TylerSeiford/Teensy4-Breakout/README.md

# Teensy4-Breakout
 Uno style breakout for Teensy4.0
