TylerSeiford/Teensy4-Breakout/Teensy4-Breakout.kicad_pcb

## KiCad design Teensy4-Breakout.kicad_pcb (2019-11-09)

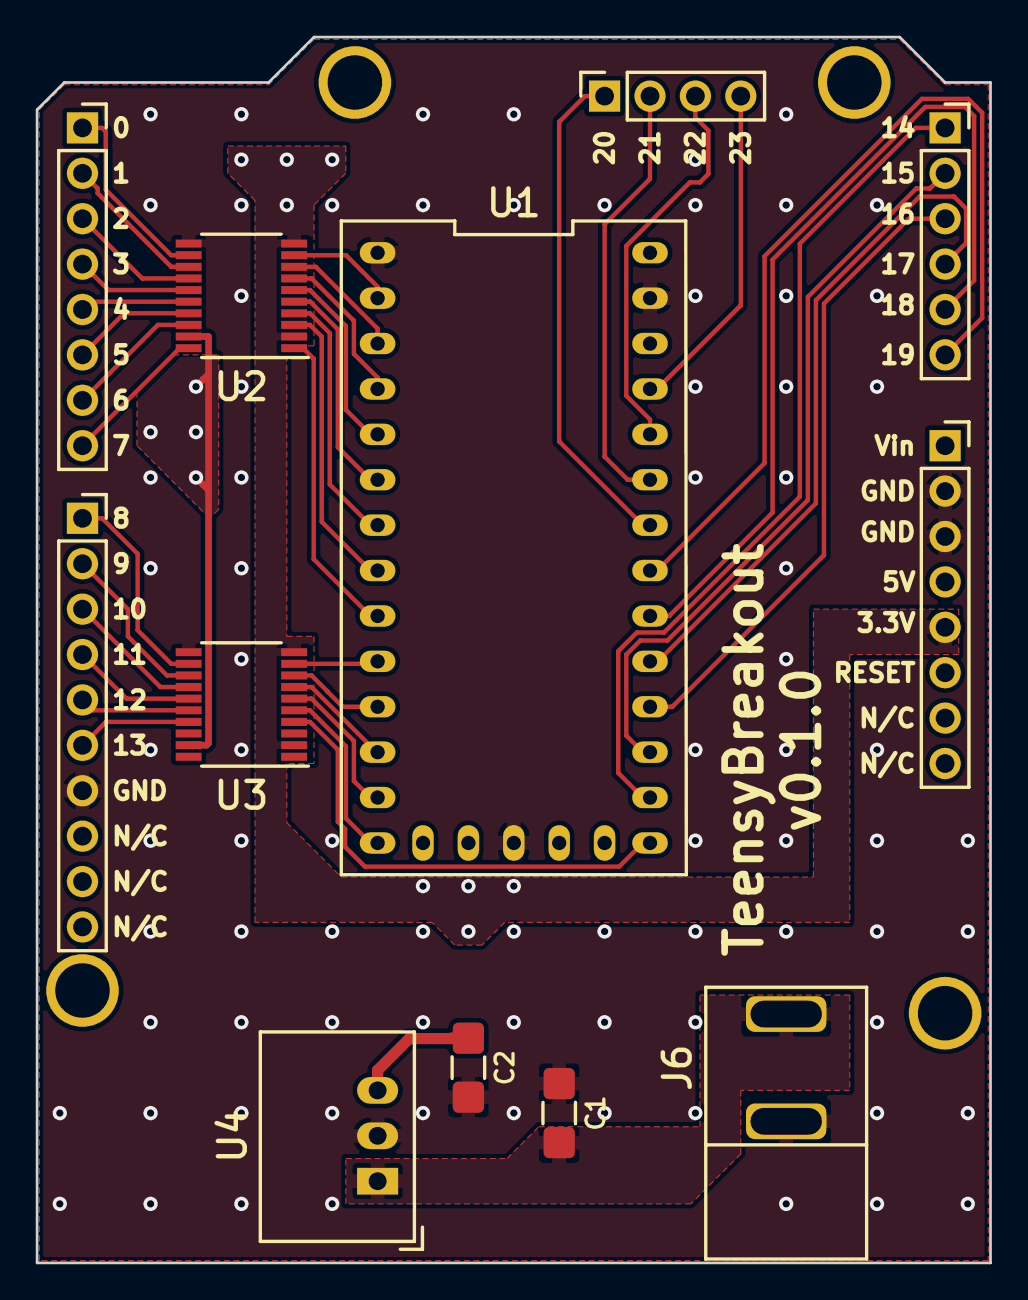
[picture p1: board Teensy4-Breakout.kicad_pcb from above]

Board: 2 copper layers, 53.3 x 68.6 mm, 16 parts (0 on the bottom side), 42 nets.

Parts:
C1, C2: 10uF; C_1206_3216Metric_Pad1.42x1.75mm_HandSolder
H1, H2, H3, H4: MountingHole; Hole
J1: DIO 0-7; J1
J2: DIO 8-13, GND, NC x 3; J2
J3: AI 6-9/DIO 20-23; J3
J4: AI 0-5/DIO 14-19; J4
J5: PWR; J5
J6: Barrel_Jack; PJ-037A
U1: Teensy4.0
U2, U3: TXB0108PWR; TSSOP-20_4.4x6.5mm_P0.65mm
U4: R-78E5.0-1.0; Converter_DCDC_RECOM_R-78E-1.0_THT

Connections:
/0-3.3: U1.2, U2.9
/0-5.0: J1.1, U2.12
/1-3.3: U1.3, U2.8
/1-5.0: J1.2, U2.13
/2-3.3: U1.4, U2.7
/2-5.0: J1.3, U2.14
/3-3.3: U1.5, U2.6
/3-5.0: J1.4, U2.15
/3.3V: J5.5, U1.16, U1.31, U2.2, U2.10, U3.2, U3.10
/4-3.3: U1.6, U2.5
/4-5.0: J1.5, U2.16
/5-3.3: U1.7, U2.4
/5-5.0: J1.6, U2.17
/5V: C2.1, J5.4, U1.33, U2.19, U3.19, U4.3
/6-3.3: U1.8, U2.3
/6-5.0: J1.7, U2.18
/7-3.3: U1.9, U2.1
/7-5.0: J1.8, U2.20
/8-3.3: U1.10, U3.9
/8-5.0: J2.1, U3.12
/9-3.3: U1.11, U3.8
/9-5.0: J2.2, U3.13
/10-3.3: U1.12, U3.7
/10-5.0: J2.3, U3.14
/11-3.3: U1.13, U3.6
/11-5.0: J2.4, U3.15
/12-3.3: U1.14, U3.5
/12-5.0: J2.5, U3.16
/13-3.3: U1.20, U3.4
/13-5.0: J2.6, U3.17
/14-3.3: J4.1, U1.21
/15-3.3: J4.2, U1.22
/16-3.3: J4.3, U1.23
/17-3.3: J4.4, U1.24
/18-3.3: J4.5, U1.25
/19-3.3: J4.6, U1.26
/20-3.3: J3.1, U1.27
/21-3.3: J3.2, U1.28
/22-3.3: J3.3, U1.29
/23-3.3: J3.4, U1.30
/GND: C1.1, C2.2, J2.7, J5.2, J5.3, J6.2, U1.1, U1.17, U1.32, U2.11, U3.11, U4.2
/Vin: C1.2, J5.1, J6.1, U4.1
