TylerSeiford/Teensy4-Breakout/LevelShifter/LevelShifter.kicad_pcb

## KiCad design LevelShifter/LevelShifter.kicad_pcb (2019-11-09)

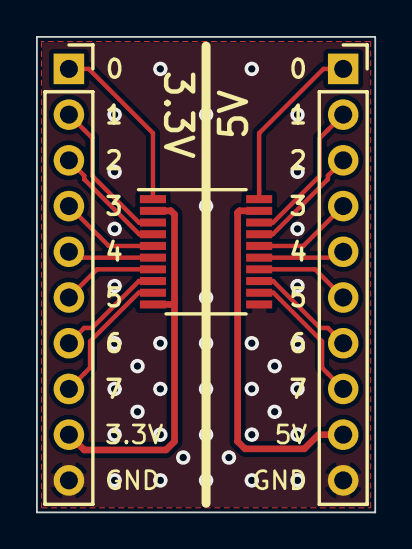
[picture p2: board LevelShifter.kicad_pcb from above]

Board: 2 copper layers, 18.8 x 26.4 mm, 3 parts (0 on the bottom side), 19 nets.

Parts:
J1, J2: Conn_01x10_Male; PinSocket_1x10_P2.54mm_Vertical
U1: TXB0108PWR; TSSOP-20_4.4x6.5mm_P0.65mm

Connections:
/0-3.3V: J2.1, U1.1
/0-5V: J1.1, U1.20
/1-3.3V: J2.2, U1.3
/1-5V: J1.2, U1.18
/2-3.3V: J2.3, U1.4
/2-5V: J1.3, U1.17
/3-3.3V: J2.4, U1.5
/3-5V: J1.4, U1.16
/3.3V: J2.9, U1.2, U1.10
/4-3.3V: J2.5, U1.6
/4-5V: J1.5, U1.15
/5-3.3V: J2.6, U1.7
/5-5V: J1.6, U1.14
/5V: J1.9, U1.19
/6-3.3V: J2.7, U1.8
/6-5V: J1.7, U1.13
/7-3.3V: J2.8, U1.9
/7-5V: J1.8, U1.12
/GND: J1.10, J2.10, U1.11
