TylerSeiford/Teensy4-Breakout/(commit log)

2019-10-01 Initial upload
    [Teensy4-Breakout.kicad_pcb, Teensy4-Breakout.sch]
2019-10-01 Fixed analog pins, switched right side to 3.3V
    V0.0.2
    [Teensy4-Breakout.kicad_pcb, Teensy4-Breakout.sch]
2019-10-13 Cleaned up traces, fixed 3.3V plane and final checks
    PCB v0.0.3
    [Teensy4-Breakout.kicad_pcb, Teensy4-Breakout.sch]
2019-10-13 Final cleanup, capacitor footprint increase
    PCB v0.0.4
    [Teensy4-Breakout.kicad_pcb, Teensy4-Breakout.sch]
2019-11-09 PCB rev 0.1.0
    [Teensy4-Breakout.kicad_pcb]
2019-11-09 Missed a few things
    [Teensy4-Breakout.kicad_pcb]
2019-11-09 Prototype Level Shifter v0.1.0
    [LevelShifter.kicad_pcb, LevelShifter.sch]
2019-11-09 Updates to header sizes
    [Teensy4-Breakout.kicad_pcb]
